KhairulIzwan/Mars-Rovers/README.md

# Mars-Rovers
RC Scale Mars Rover -- Implementation of ROS
