KhairulIzwan/Mars-Rovers/Drawing/STLs/MainBearingHolder.STL

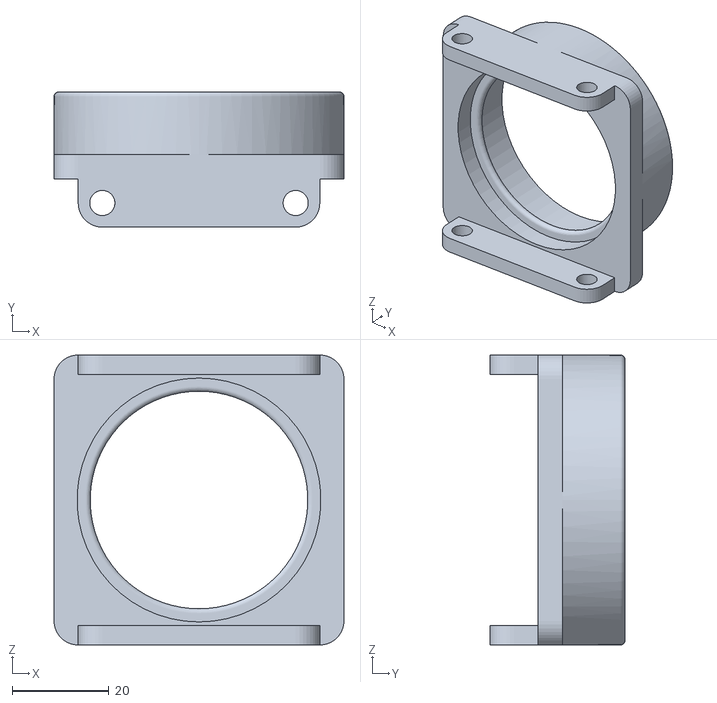
[picture p1: CAD file, 2019-02-13]
Drawing/STLs/MainBearingHolder.STL
60.0 x 28.0 x 60.0
