KhairulIzwan/Mars-Rovers/Drawing/STLs/MainSuspentionHolder.STL

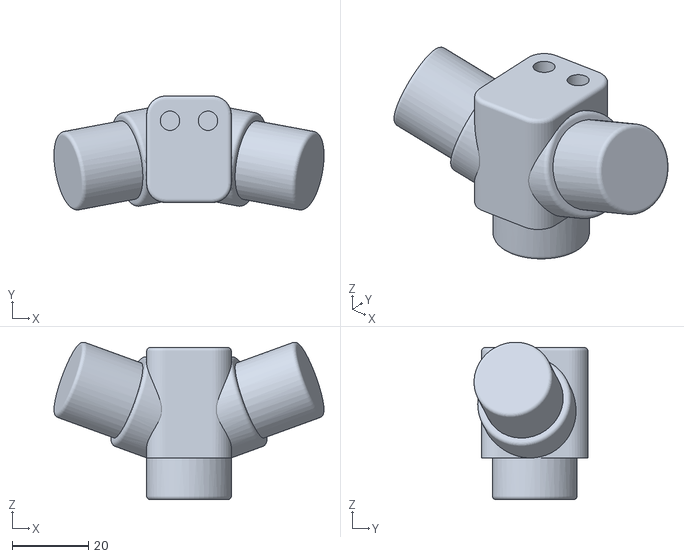
[picture p2: CAD file, 2019-02-13]
Drawing/STLs/MainSuspentionHolder.STL
71.0 x 30.0 x 41.4
