KhairulIzwan/Mars-Rovers/Drawing/STLs/MainAntirollbar.STL

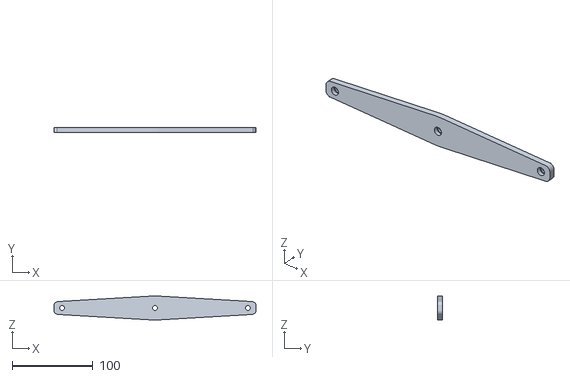
[picture p3: CAD file, 2019-02-13]
Drawing/STLs/MainAntirollbar.STL
250.0 x 6.00 x 29.7
