KhairulIzwan/Mars-Rovers/Drawing/Drawing_15cm.stl

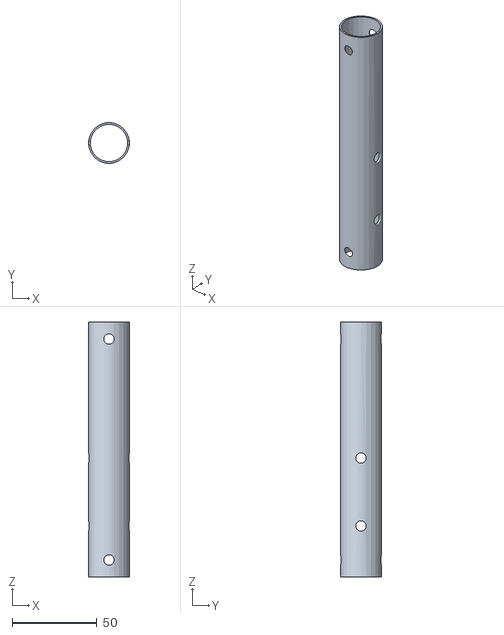
[picture p4: CAD file, 2019-02-13]
Drawing/Drawing_15cm.stl
24.0 x 24.0 x 150.0
