KhairulIzwan/Mars-Rovers/Drawing/STLs/AntirollBarLink.STL

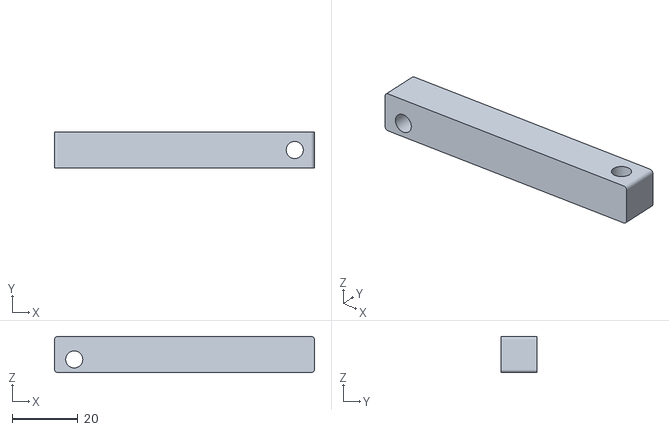
[picture p5: CAD file, 2019-02-13]
Drawing/STLs/AntirollBarLink.STL
79.0 x 11.0 x 11.0
