KhairulIzwan/Mars-Rovers/Drawing/STLs/ConstructionPart2.STL

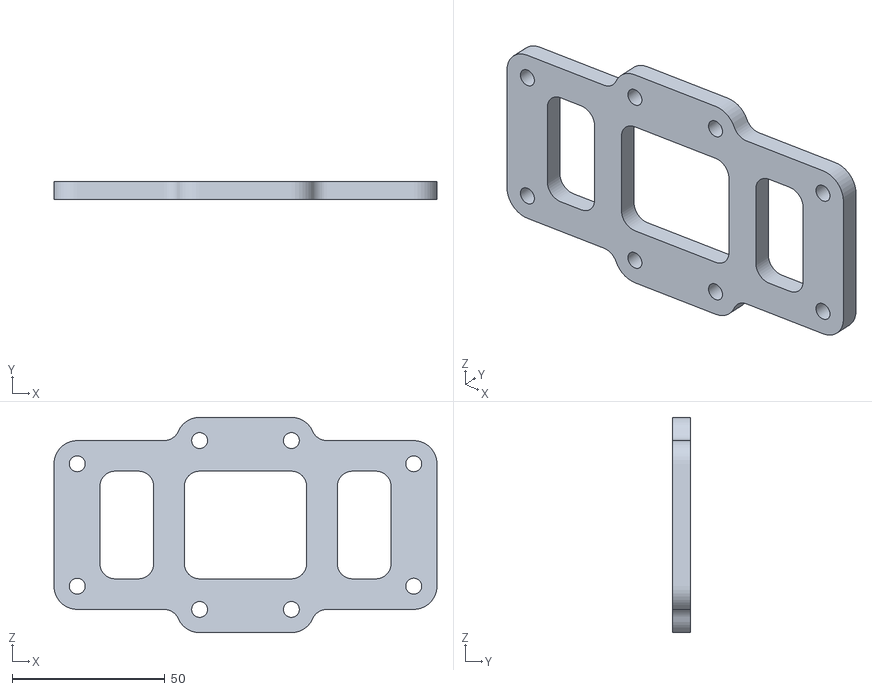
[picture p6: CAD file, 2019-02-13]
Drawing/STLs/ConstructionPart2.STL
125.2 x 6.00 x 70.4
