KhairulIzwan/Mars-Rovers/Drawing/Drawing_13cm.stl

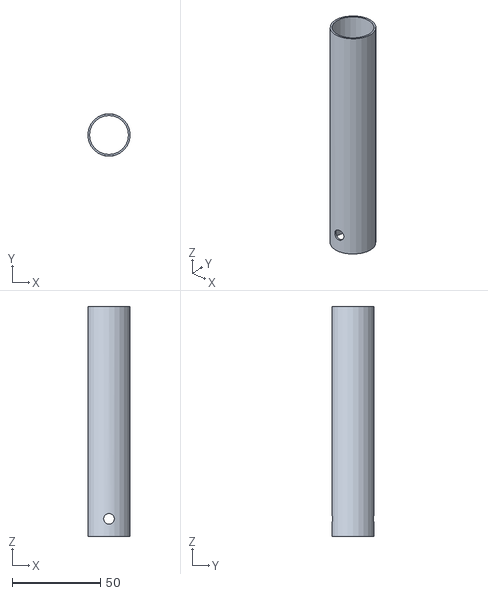
[picture p7: CAD file, 2019-02-13]
Drawing/Drawing_13cm.stl
24.0 x 24.0 x 130.0
