KhairulIzwan/Mars-Rovers/Drawing/STLs/Bearing.stl

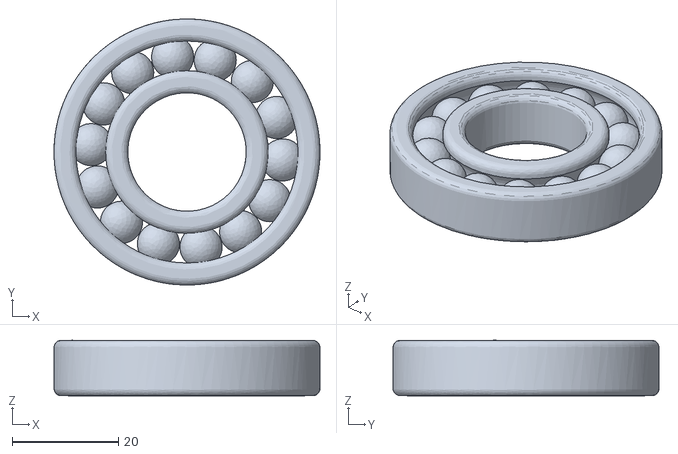
[picture p8: CAD file, 2019-02-13]
Drawing/STLs/Bearing.stl
50.0 x 50.0 x 10.4
