KhairulIzwan/Mars-Rovers/Drawing/Drawing_18cm.stl

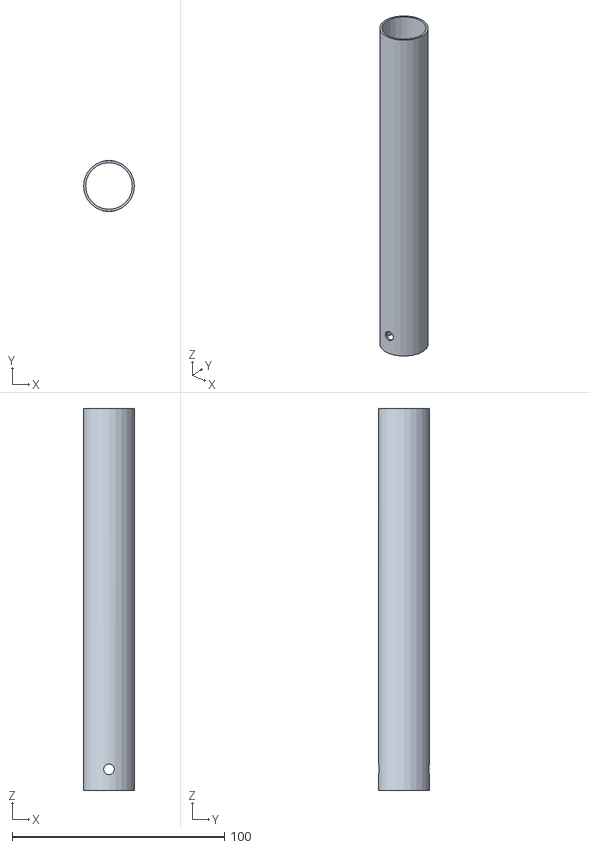
[picture p9: CAD file, 2019-02-13]
Drawing/Drawing_18cm.stl
24.0 x 24.0 x 180.0
