KhairulIzwan/Mars-Rovers/Drawing/STLs/Wheel.STL

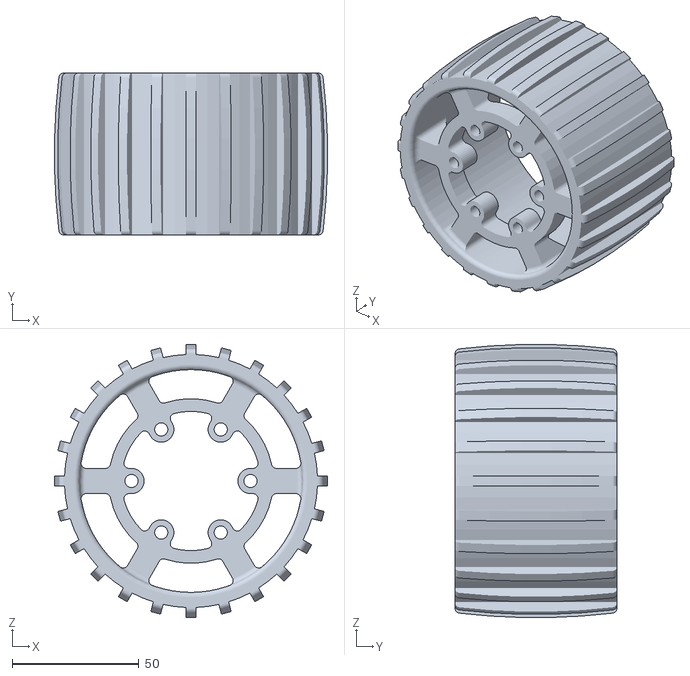
[picture p10: CAD file, 2019-02-13]
Drawing/STLs/Wheel.STL
107.9 x 64.0 x 107.9
