KhairulIzwan/Mars-Rovers/Drawing/STLs/ConstructionElement.STL

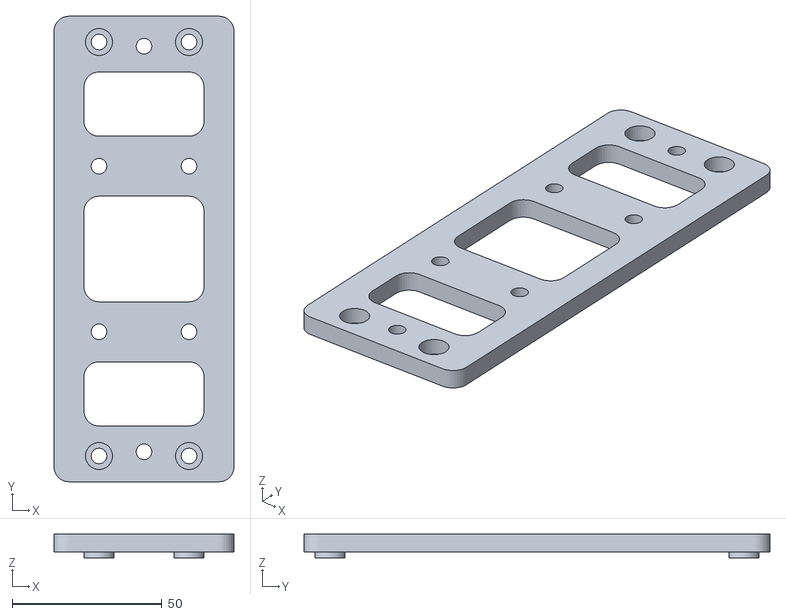
[picture p11: CAD file, 2019-02-13]
Drawing/STLs/ConstructionElement.STL
60.0 x 155.2 x 8.00
