KhairulIzwan/Mars-Rovers/Drawing/STLs/SuspentionRollBarlink.STL

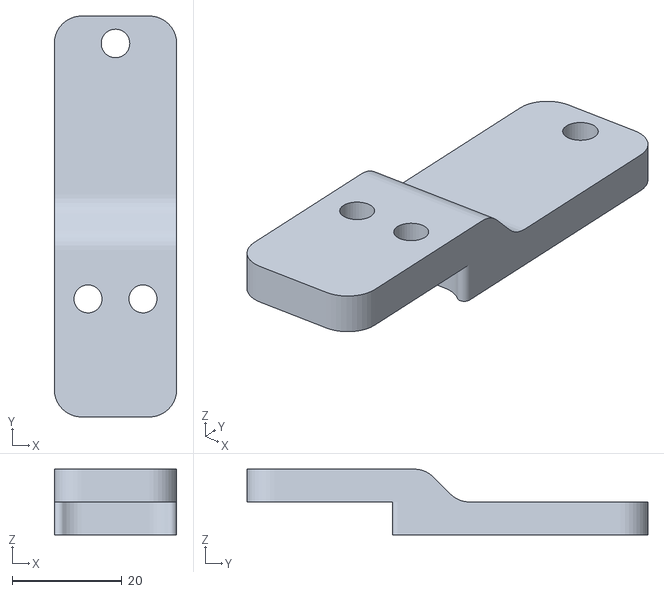
[picture p12: CAD file, 2019-02-13]
Drawing/STLs/SuspentionRollBarlink.STL
22.3 x 73.0 x 12.0
