KhairulIzwan/Mars-Rovers/Drawing/STLs/WheelInsidePart.STL

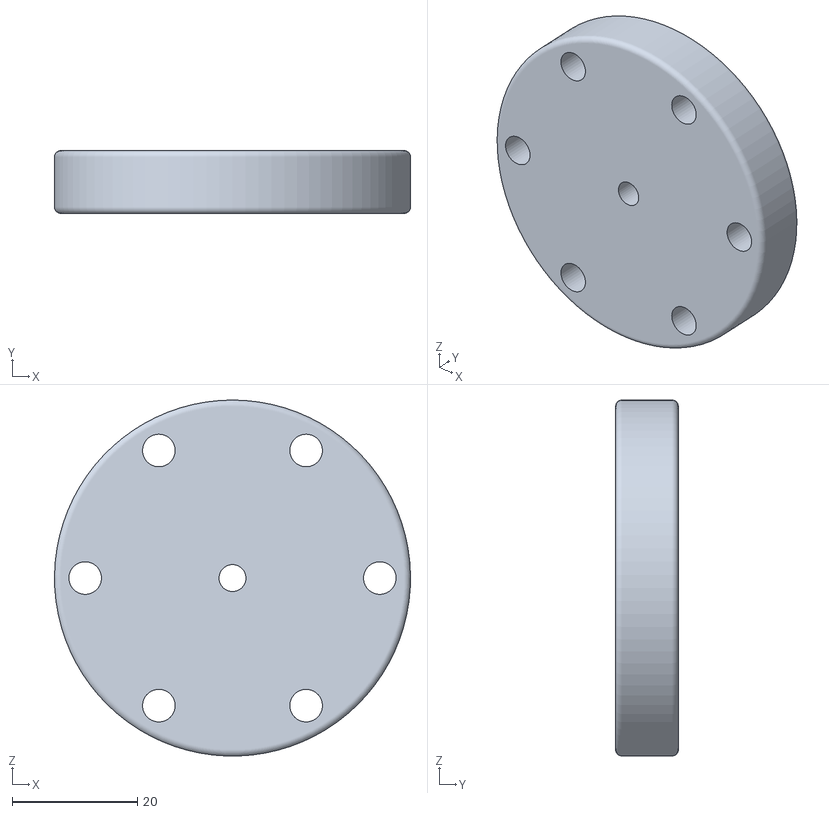
[picture p13: CAD file, 2019-02-13]
Drawing/STLs/WheelInsidePart.STL
56.8 x 10.0 x 56.8
