KhairulIzwan/Mars-Rovers/Drawing/STLs/WheelBearingHub.STL

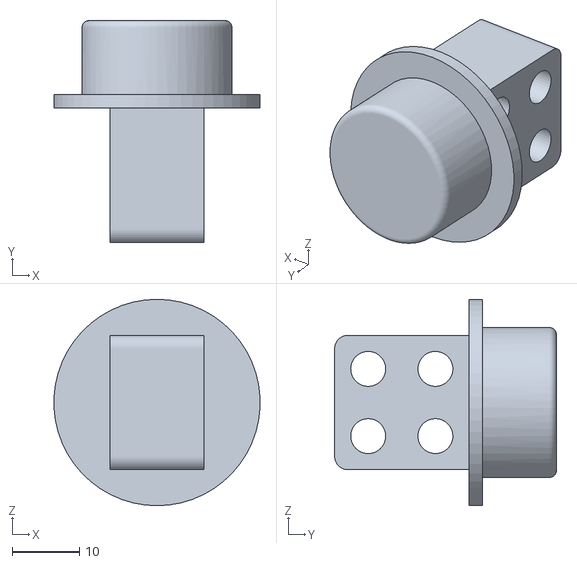
[picture p14: CAD file, 2019-02-13]
Drawing/STLs/WheelBearingHub.STL
30.6 x 33.0 x 30.7
