KhairulIzwan/Mars-Rovers/Drawing/STLs/RearSuspentionBearingHolder.STL

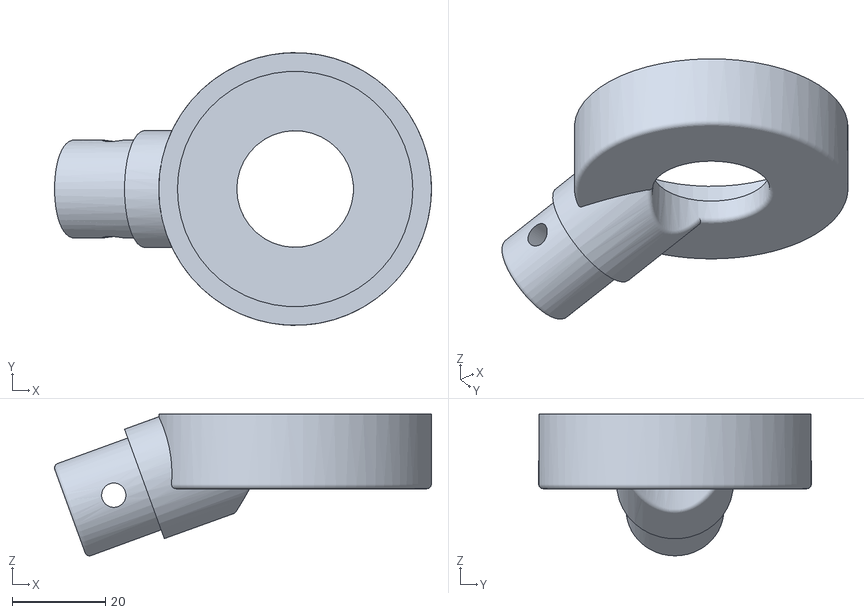
[picture p15: CAD file, 2019-02-13]
Drawing/STLs/RearSuspentionBearingHolder.STL
80.8 x 58.4 x 30.4
