KhairulIzwan/Mars-Rovers/Drawing/STLs/Chassis.STL

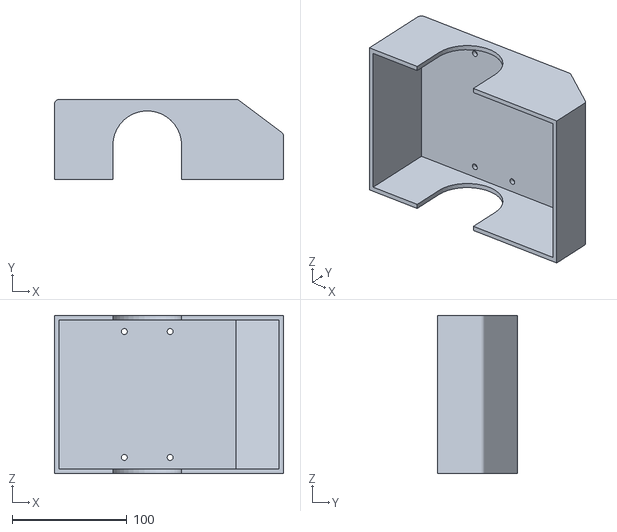
[picture p16: CAD file, 2019-02-13]
Drawing/STLs/Chassis.STL
200.0 x 70.0 x 138.0
