KhairulIzwan/Mars-Rovers/Drawing/STLs/FrontWheelCoupler.STL

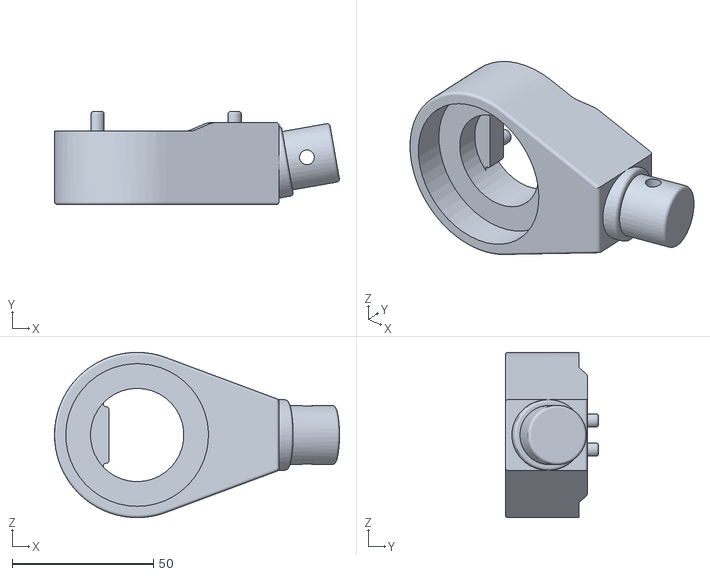
[picture p17: CAD file, 2019-02-13]
Drawing/STLs/FrontWheelCoupler.STL
100.8 x 33.0 x 58.4
