KhairulIzwan/Mars-Rovers/Drawing/STLs/MotorHolder.STL

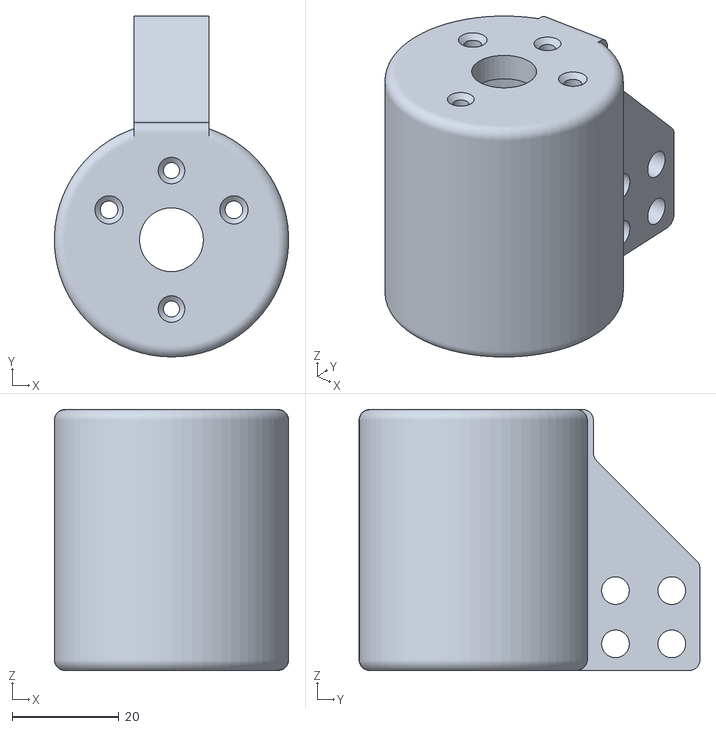
[picture p18: CAD file, 2019-02-13]
Drawing/STLs/MotorHolder.STL
44.0 x 64.0 x 49.0
