KhairulIzwan/Mars-Rovers/Drawing/STLs/WheelArc.STL

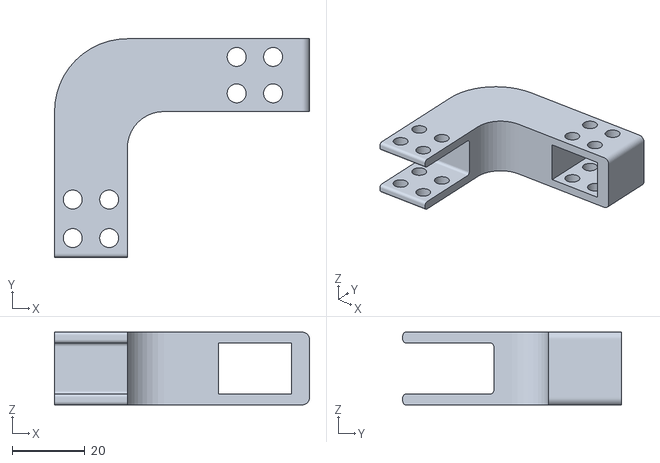
[picture p19: CAD file, 2019-02-13]
Drawing/STLs/WheelArc.STL
70.0 x 60.0 x 20.0
