KhairulIzwan/Mars-Rovers/Drawing/STLs/HeadHolder.STL

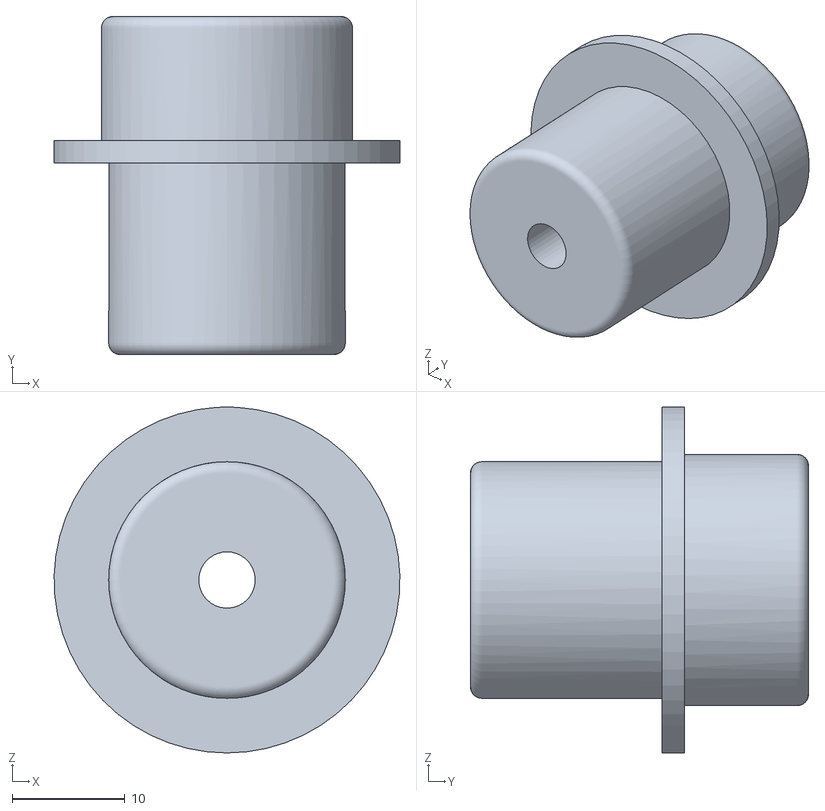
[picture p20: CAD file, 2019-02-13]
Drawing/STLs/HeadHolder.STL
30.7 x 30.0 x 30.7
