KhairulIzwan/Mars-Rovers/Drawing/STLs/Head.STL

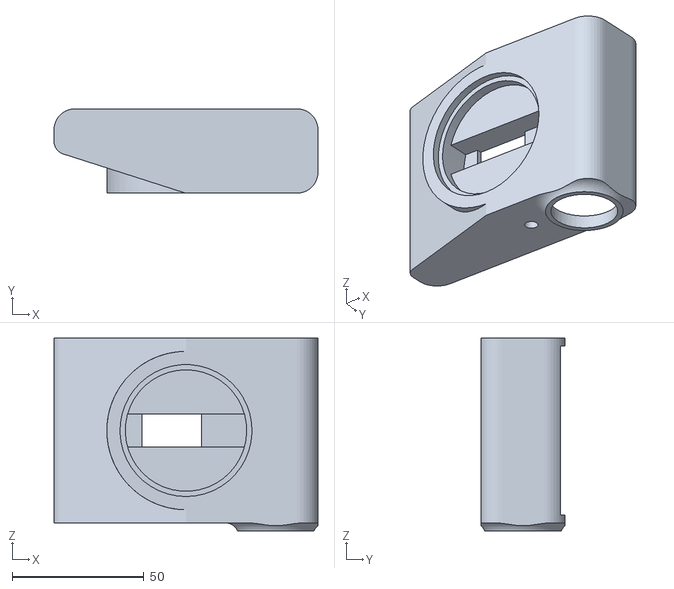
[picture p21: CAD file, 2019-02-13]
Drawing/STLs/Head.STL
100.0 x 32.0 x 73.0
