KhairulIzwan/Mars-Rovers/Drawing/STLs/RearWheelCoupler.STL

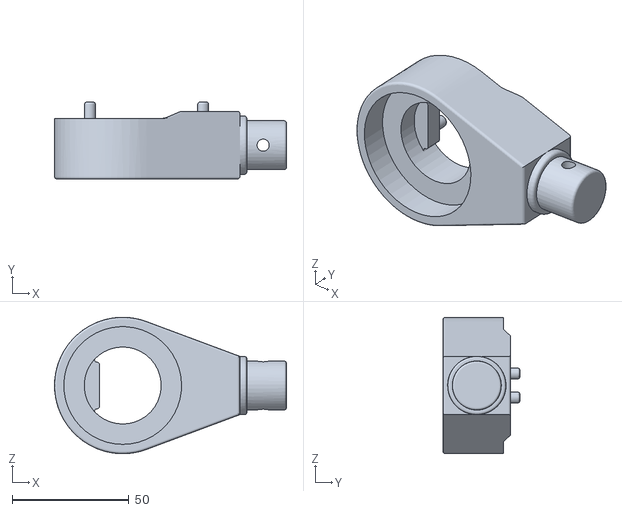
[picture p22: CAD file, 2019-02-13]
Drawing/STLs/RearWheelCoupler.STL
99.4 x 33.0 x 58.4
