KhairulIzwan/Mars-Rovers/Drawing/STLs/RearSuspentionBearingCoupler.STL

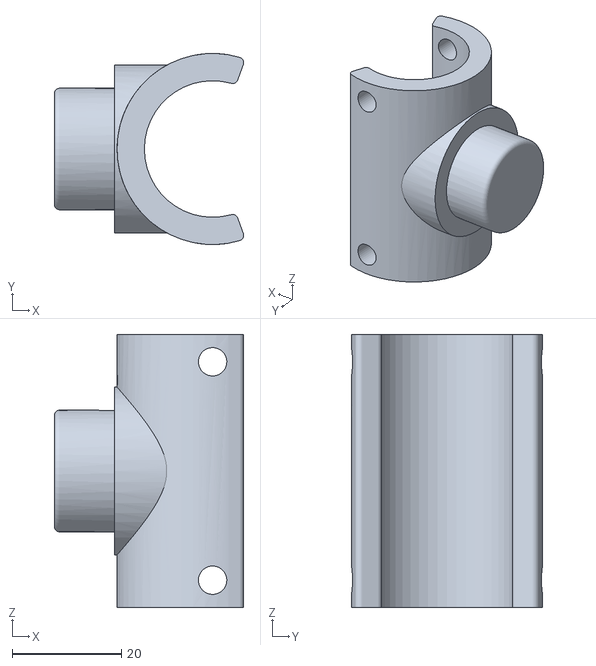
[picture p23: CAD file, 2019-02-13]
Drawing/STLs/RearSuspentionBearingCoupler.STL
34.7 x 35.0 x 50.0
