KhairulIzwan/Mars-Rovers/(list of files, cad)

Other CAD files:
Drawing/Drawing_18cm 3.dwg
Drawing/Drawing_13cm 3.dwg
Drawing/Drawing_13cm.dwg
Drawing/Drawing_15cm.dwg
Drawing/Drawing_18cm.dwg
